IceUnicorn93/PVK-Controller/docs/_posts/2026-03-04-welcome-to-pvk-console.md

---
layout: post
title: "Welcome to the PVK Console Project"
date: 2026-03-04
permalink: /posts/welcome-to-pvk-console/
---

🎉 **We're thrilled to announce the launch of the PVK Console project blog!**

This ambitious project aims to create an open-source desktop replica of the legendary PVKK planetary defense console. Our mission is to build a fully functioning version that not only looks authentic but captures the spirit and interactive experience of the original.

---

## 🎯 Project Vision

The PVK Console represents more than just a replica – it's a tribute to innovative design and interactive technology. We're committed to:

- ✨ **Authenticity**: Staying true to the original design while adding modern improvements
- 🔓 **Open Source**: Making all designs, code, and documentation freely available
- 🌍 **Community-Driven**: Building this together with passionate contributors worldwide
- 🎓 **Educational**: Providing detailed documentation for learning and experimentation

---

## 📅 What's Coming Up?

Over the coming weeks and months, you can expect:

### 🛠️ Development Updates
- Weekly progress reports on hardware and software development
- Behind-the-scenes look at design decisions
- Prototyping milestones and testing results

### 🔬 Technical Deep-Dives
- PCB design and component selection
- Firmware architecture and programming
- Desktop application development with C#
- Integration and communication protocols

### 🏆 Community Showcase
- Contributor spotlights and interviews
- Community builds and modifications
- Tips, tricks, and best practices

### 📖 Build Guides
- Step-by-step assembly instructions
- Parts sourcing guides
- Troubleshooting and FAQ

---

## Current Status
We have successfully completed the first prototype PCB. We are finalizing the firmware and adding the last features. The desktop application is just for testing purposes, but we will be adding more features and improving the UI in the coming weeks. We are also working on the documentation as well as the schematics and PCB design. We are positive that we will be able to release the first mod version of the console shortly after the game is released.

Here is a sneak peek of the current prototype PCB in action:
(https://youtu.be/W_m9zAJIbgY)

## 🤝 Join the Mission!

This is a **community project**, and we need **YOU**!

### How You Can Contribute:

| Area | Skills Needed | Get Started |
|---|---|---|
| 🔌 **Hardware** | PCB design, electronics, CAD | Design schematics and PCB layouts |
| 💾 **Firmware** | C/C++, embedded systems | Develop microcontroller code |
| 💻 **Software** | C#, .NET, UI/UX design | Build the desktop application |
| 📝 **Documentation** | Technical writing | Create guides and tutorials |
| 🎨 **Design** | Graphics, 3D modeling | Create assets and enclosure designs |
| 🧪 **Testing** | Quality assurance | Test prototypes and report bugs |

### Ready to Get Started?

👉 **Check out our [GitHub Repository](https://github.com/IceUnicorn93/PVK-Controller)**

- Browse the codebase and documentation
- Pick an issue labeled "good first issue"
- Join discussions and share your ideas
- Fork the repo and submit pull requests

---

## 💬 Stay Connected

Follow this blog for regular updates, and don't hesitate to reach out with questions, suggestions, or just to say hello!

Let's build something amazing together! 🚀

---

*Posted by the PVK Console Team on March 4, 2026*
