IceUnicorn93/PVK-Controller/documentation/Upper Center PCB.docx

PVKK Upper Center PCB

Inputs

Input | Type | ESP32 Pin
Amunition Type | Buttons | 36
Load | Button | 39
Prime 1 | Button | 34
Prime 2 | Button | 35
Prime 3 | Button | 32
Chamber | Button | 33
Clear 1 | Button | 25
Clear 2 | Button | 26
Clear 3 | Button | 27
Clear 4 | Button | 13

Outputs

Output | Type | ESP32 Pin
LED Indicators | WS2812B LED Strip (137 LEDs) | 23
I2C SDA | I2C Mux SDA | 21
I2C SCL | I2C Mux SCL | 22

LED Indicators

From | To | LEDs | Descriptor | Color 1 ( R, G, B) | Color 2 ( R, G, B)
0 | 0 | 1 | Load | 126, 250, 239 | 126, 250, 239
1 | 1 | 1 | Laser | 163, 226, 203 | 163, 226, 203
2 | 2 | 1 | HE | 163, 226, 203 | 163, 226, 203
3 | 3 | 1 | Clear Chamber | 255, 246, 162 | 255, 246, 162
4 | 13 | 10 | Heat Indicator | 255, 169, 57 | 255, 169, 57
14 | 14 | 1 | KWG | 163, 226, 203 | 163, 226, 203
15 | 15 | 1 | PGM | 163, 226, 203 | 163, 226, 203
16 | 16 | 1 | Prime 1 Ready | 127, 250, 240 | 127, 250, 240
17 | 17 | 1 | Prime 2 Ready | 127, 250, 240 | 127, 250, 240
18 | 18 | 1 | Prime 3 Ready | 127, 250, 240 | 127, 250, 240
20 | 52 | 33 | Prime 3 Progress | 252, 194, 72 | 252, 194, 72
85 | 53 | 33 | Prime 2 Progress | 252, 194, 72 | 252, 194, 72
86 | 118 | 33 | Prime 1 Progress | 252, 194, 72 | 252, 194, 72
119 | 119 | 1 | Prime 1 Done | 145, 250, 247 | 145, 250, 247
120 | 120 | 1 | Prime 2 Done | 145, 250, 247 | 145, 250, 247
121 | 121 | 1 | Prime 3 Done | 145, 250, 247 | 145, 250, 247
122 | 122 | 1 | Target 4 Located | 168, 249, 243 | 168, 249, 243
123 | 123 | 1 | Target 3 Located | 168, 249, 243 | 168, 249, 243
124 | 124 | 1 | Target 2 Located | 168, 249, 243 | 168, 249, 243
125 | 125 | 1 | Target 1 Located | 168, 249, 243 | 168, 249, 243
126 | 126 | 1 | Chamber Ready | 252, 246, 54 | 252, 246, 54
134 | 127 | 8 | Energy (Yellow)
136 | 135 | 2 | Energy (Red)

Protocol

The Protocol is simple. We the ESP32 assumes that it will receive 143 bytes!
0 – 136 is for the LEDs. (0 = Off, 1 = Primary Color, 2 = Secondary Color)
137 LED Brightness
138 Selected Ammo (0 = Nothing | 1 = KWG | 2 = PGM | 3 = HE | 4 = Laser)
139 KWG Amount
140 PGM Amount
141 HE Amount
142 Laser Amount
