IceUnicorn93/PVK-Controller/firmware/shared/14SegFont.h

/*
  Fontname: Untitled
  Copyright: Created with Fony 1.4.7
  Glyphs: 95/256
  BBX Build Mode: 0
*/
const uint8_t MySegmentFont46px[3833] U8G2_FONT_SECTION("MySegmentFont46px") = 
  "_\0\5\5\5\6\6\6\6\33*\0\0*\0*\0\4\336\12[\16\334 \6\0\0\301\35!\12\302"
  "+\301\35|\340\61\10\42\14\3b\355\35|\300\11A\0\0#O\325\13\301\35\11(PA\12T\200"
  "\204$ !\11(P\2\12T\200\4\25 \241Lbf\2$\250\0\11I@B\22P\240\4\24\250"
  "\0\11*@B\22\220P\250@+\1\22\222\200\204$\240@\5)P\1\22T\200\204$ !\11("
  "@\0$gY\15\301}L\245\32\65\42\244a\11iXB\32\226\220\206%\244a\11iXB\32\226"
  "\220\206%\244a\11iXB\32\226\220\206%\244a\11iXB\32\226E\354\326\220\204\65$a\15I"
  "XC\22\326\220\204\65$a\15IXC\22\326\220\204\65$a\15IXC\22\326\220\204\65$a\15"
  "I\30\226\260FU\246\1\0%P\231\14\307\35\10W\210\2\21\240P\4(\24\341\11Fp\203\21\234"
  "p\204\66\34\241\11Hh\2\22Z\220\204\26$\341\212\373`C\270b)hB\12\232\200\204& \241"
  "\11gh\302\21\234`\6'\30\341\11exB\21\240@\6(\20!\12W\0&Y\366\33\301\35\21"
  "\20i\312\32\12\241\204\63\244\1\11i@B\32\220\240\4$\250\301\14j(\3\33\4\341\216gz\207"
  "#\304\300\6B\30A\14\206(B\30\320P\204 \250\201\10AX\203\30\202\260\16!\60C\10\255\20"
  "\202\33\306\300\212\61\250C\20'\31\316\30\210R\204\0\0'\14\3b\355\35|\300\11A\0\0(\32"
  "W\15\301}L\243\12\65!T\361\377\373\240\42T\361\377\253\325\250\215)\0)\32W\35\301=L\243"
  "\22\266*\376\377>\250\10U\374\377\302\7\232P\215i\0*QU\34\311]\10M \303\22\214\260\4"
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
  "W\15\301}L\243\12\65!T\361\377\373\240\42T\361\377\253\325\250\215)\0|\16Cd\311\35|\300"
  "\11\1\12\302\7\34}\32W\35\301=L\243\22\266*\376\377>\250\10U\374\377\302\7\232P\215i\0"
  "~\21\323\30\361]\24,Q\213\31\14\243\220F\14\0\0\0\0\4\377\377\0";
