IceUnicorn93/PVK-Controller/(commit log)

2026-03-07 Added first draft for the Protocol and SPI Master Slave Communication
2026-03-23 SPI Integration Hell
    First Code of Master Gateway as well as new Code for the Upper Center Console for SPI Communication
2026-03-29 Weekly Update and simple SPI test.
2026-04-06 Weekly Update | SPI Working and Custom Font
2026-04-20 Weekly Update - Multiple SPI Slaves
